Casseles/pcie_to_sata/docs/images/bottom.png

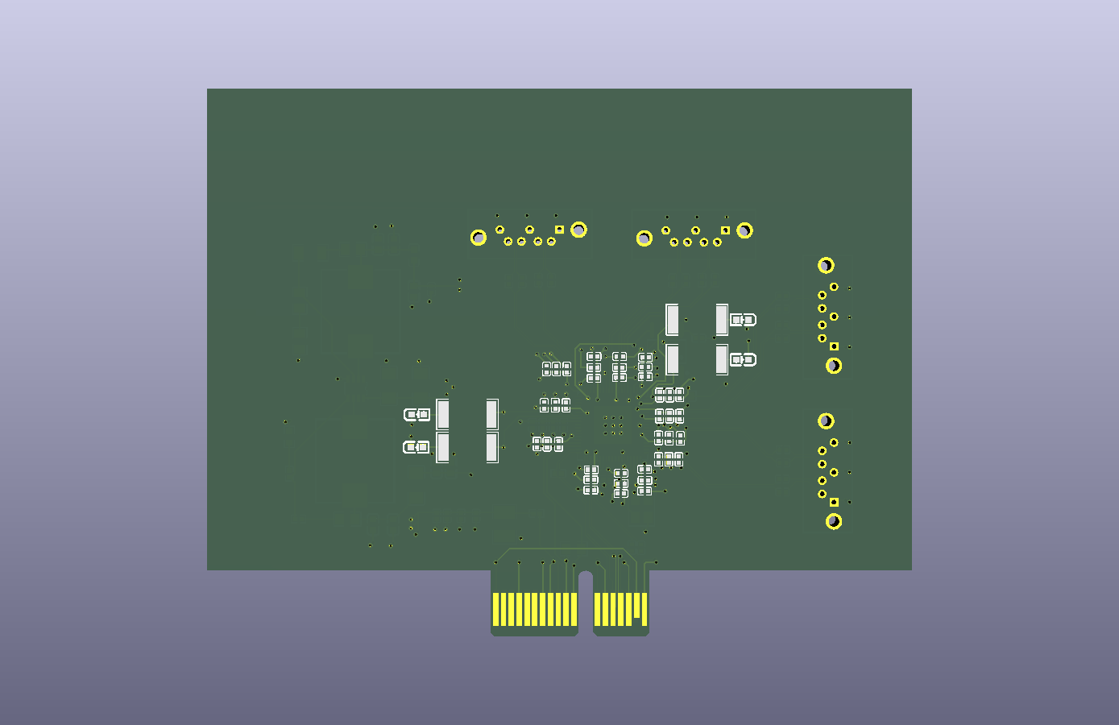
docs/images/bottom.png
