Casseles/pcie_to_sata/docs/images/bottom_raytracing.png

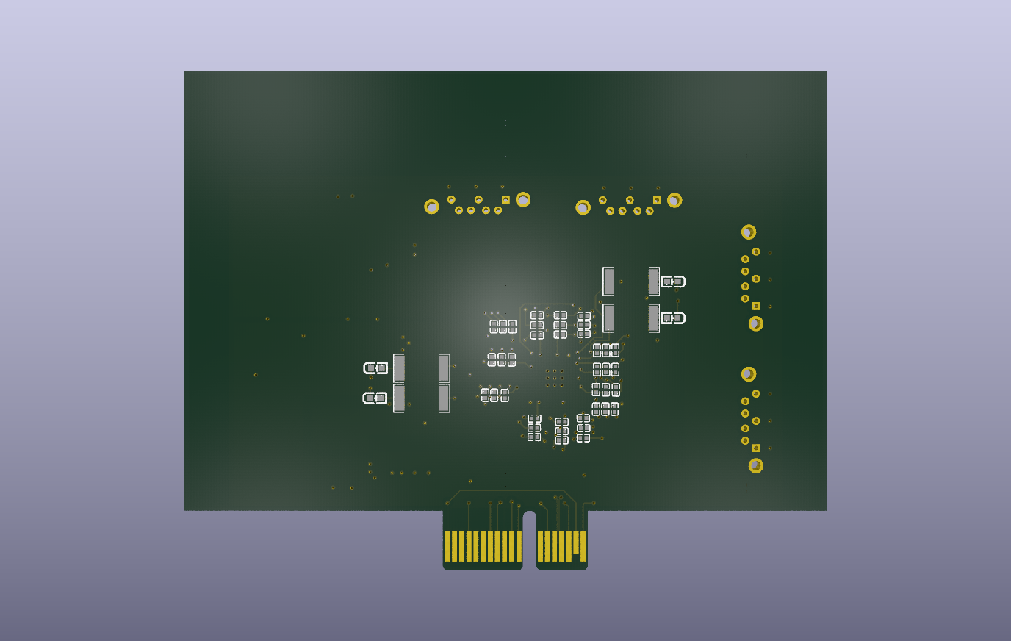
docs/images/bottom_raytracing.png
