Casseles/pcie_to_sata/docs/images/top.png

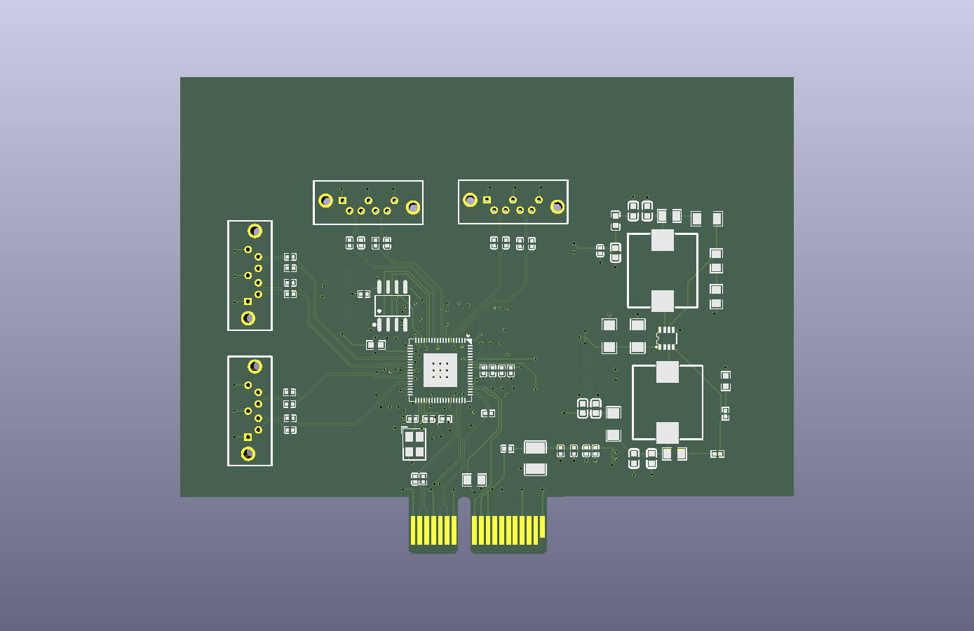
docs/images/top.png
