Casseles/pcie_to_sata/manufacturing/Gerber_bom.csv

Designator | Footprint | Quantity | Value | LCSC Part #
C1, C11, C12, C15, C16, C2, C20, C23, C24, C25, C26, C27, C49, C5, C53, C59, C60, C65, C66, C71, C72 | C0402 | 21 | .1u | C85735
C10, C14 | C1206 | 2 | 22u | C1859
C13 | C0603 | 1 | 1u | C1691
C17 | C1210 | 1 | 100u | C90143
C18, C19, C22, C28, C50, C55, C56, C62, C68 | C0402 | 9 | .01u | C85735
C21, C57, C63, C69 | C0402 | 4 | 1000p | C85735
C29, C31, C32, C33, C34, C35, C36, C37, C38, C39, C40, C41, C42, C43, C44, C45, C46, C58, C61, C64, C67, C70, C73 | C0402 | 23 | .01u | C1523
C3, C54, C77, C8 | C0402 | 4 | .1u | C1525
C30 | C0402 | 1 | 1000p | C1523
C4, C51, C52, C6 | C0603 | 4 | 10u | C1691
C47, C48 | C0402 | 2 | 18p | C1523
C7, C9 | C0603 | 2 | 2.2u | C1691
C74, C76, C78, C79 | C0402 | 4 | .01u | C1525
C75 | C0402 | 1 | 1000p | C1525
D1, D2, D3, D4 | LED-SMD_L1.6-W0.8-R-RD | 4 | LED | C2286
FB1 | L0603 | 1 | FerriteBead | C963848
FB2 | L1206 | 1 | FerriteBead | C16902
J1, J2, J3, J4 | CONN-TH_SATA-501-M07S1BY-A | 4 | ~ | C7500838
J5 | BUS_PCIexpress_x1 | 1 | Bus_PCI_Express_x1
L1, L2 | IND-SMD_L10.8-W10.2_IHLP4040DZER1R8M11 | 2 | 1.5u | C845071
R1 | R0805 | 1 | 4,7k | C1404
R10 | R0805 | 1 | 390k | C1404
R11 | R0805 | 1 | 22k | C17560
R12 | R0402 | 1 | 0 | C17168
R13 | R0805 | 1 | 560k | C1404
R14 | R0402 | 1 | 39k | C25076
R15 | R0402 | 1 | 910k | C11866
R16, R4 | R0603 | 2 | 10k | C15401
R2 | R0402 | 1 | 6.04k | C25913
R3 | R0805 | 1 | 750k | C1404
R5 | R1206 | 1 | 56k | C4513
R6, R7, R8, R9 | R2512 | 4 | 100 | C15262
RN1 | R0402 | 1 | 100 | C425365
U1 | QFN-76_L9.0-W9.0-P0.40-TL-EP4.9 | 1 | ~ | C713244
U2 | TSOT-23-8_L2.9-W1.6-P0.65-LS2.8-BL | 1 | ~ | C3194324
U3 | SOP-8_L5.0-W4.0-P1.27-LS6.0-BL | 1 | FM25Q08B-SO-T-G | C696825
X1 | CRYSTAL-SMD_4P-L3.2-W2.5-BL-2 | 1 | X322525MSB4SI | C13740
