Casseles/pcie_to_sata/docs/schematics.pdf

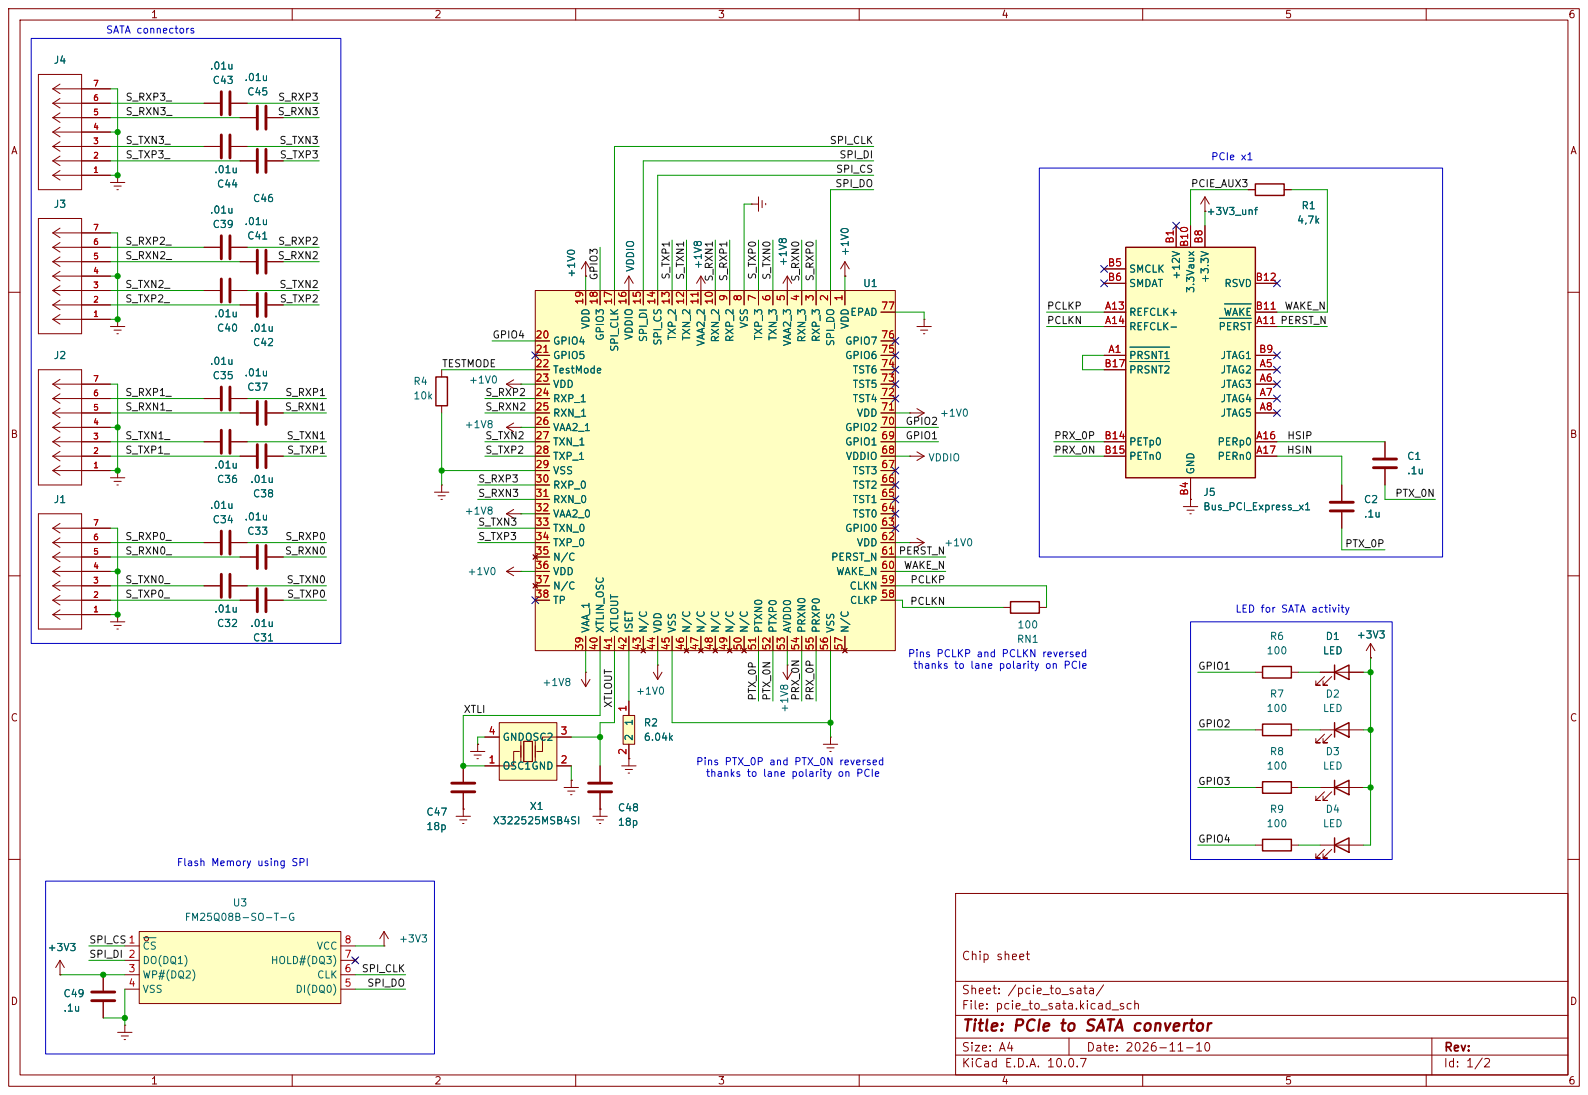
[picture p5: page 1]

PCIe x1 Pins PTX_0P and PTX_0N reversed

LED for SATA activity Pins PCLKP and PCLKN reversed

thanks to lane polarity on PCIe

thanks to lane polarity on PCIe C47

Flash Memory using SPI

Sheet: /pcie_to_sata/
File: pcie_to_sata.kicad_sch
Title: PCIe to SATA convertor

Size: A4 | Rev:
KiCad E.D.A. 10.0.7 | Id: 1/2

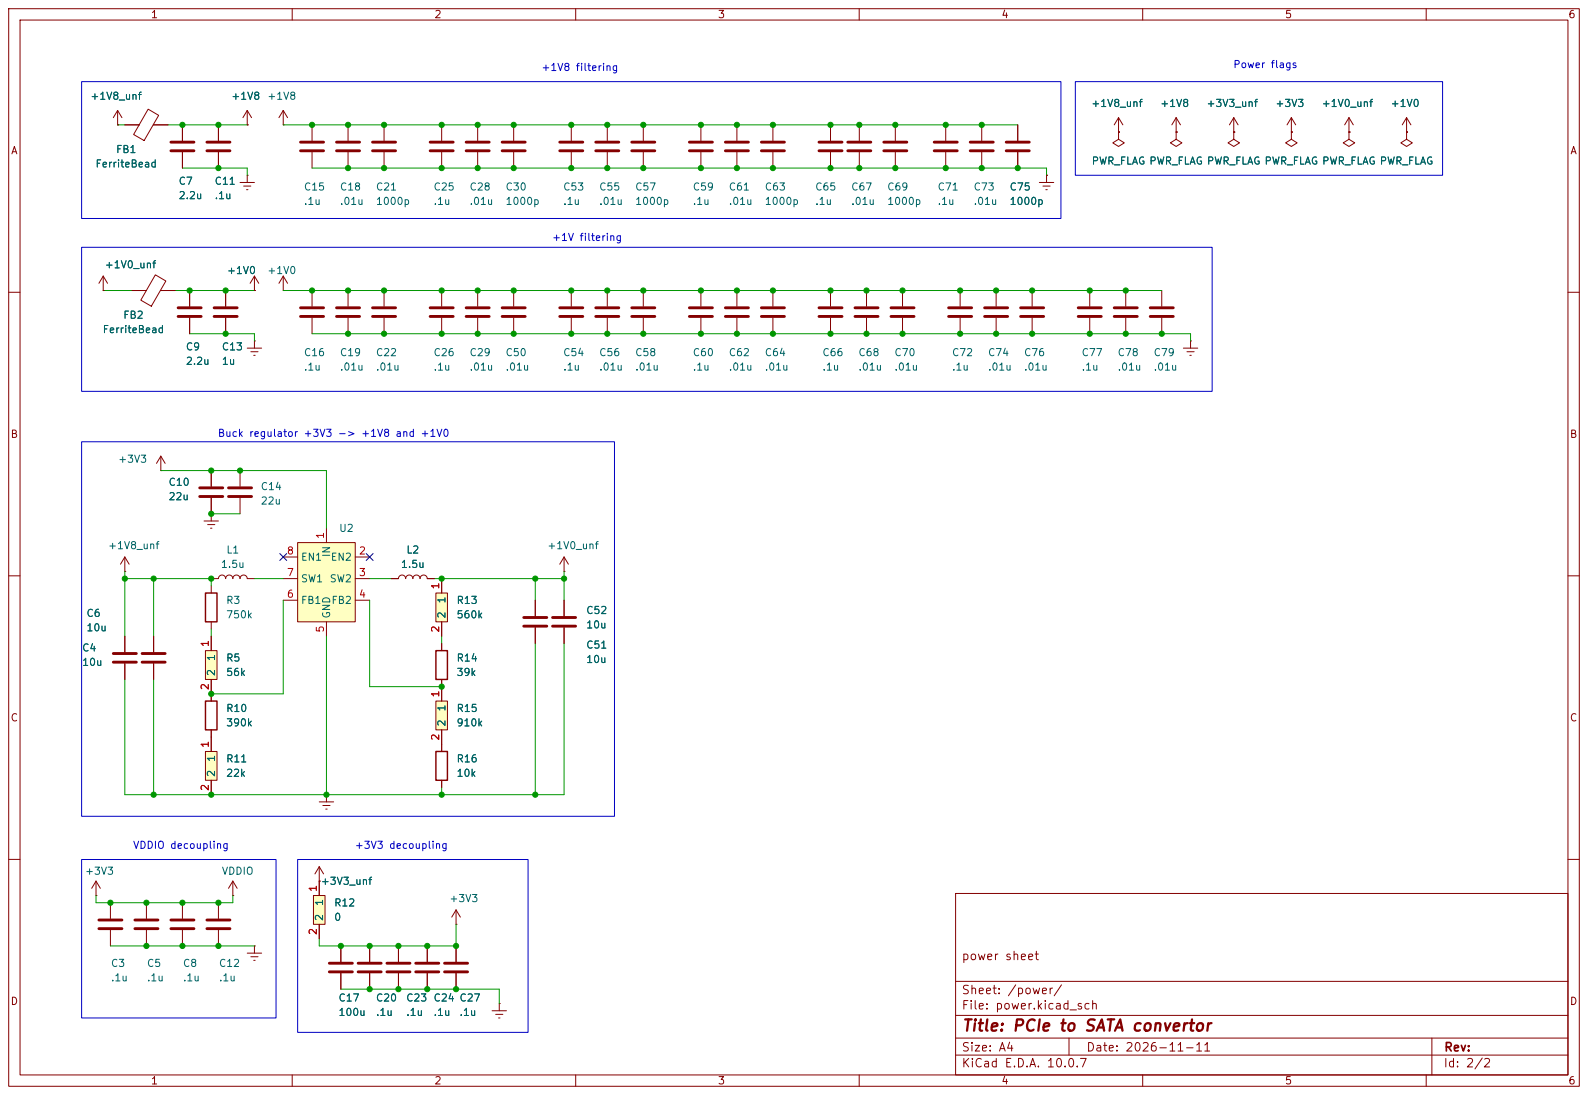
[picture p6: page 2]

Sheet: /power/
File: power.kicad_sch
Title: PCIe to SATA convertor

Size: A4 | Rev:
KiCad E.D.A. 10.0.7 | Id: 2/2
