Casseles/pcie_to_sata/hardware/pcie_to_sata.kicad_pcb

## KiCad design hardware/pcie_to_sata.kicad_pcb (2026-11-11)

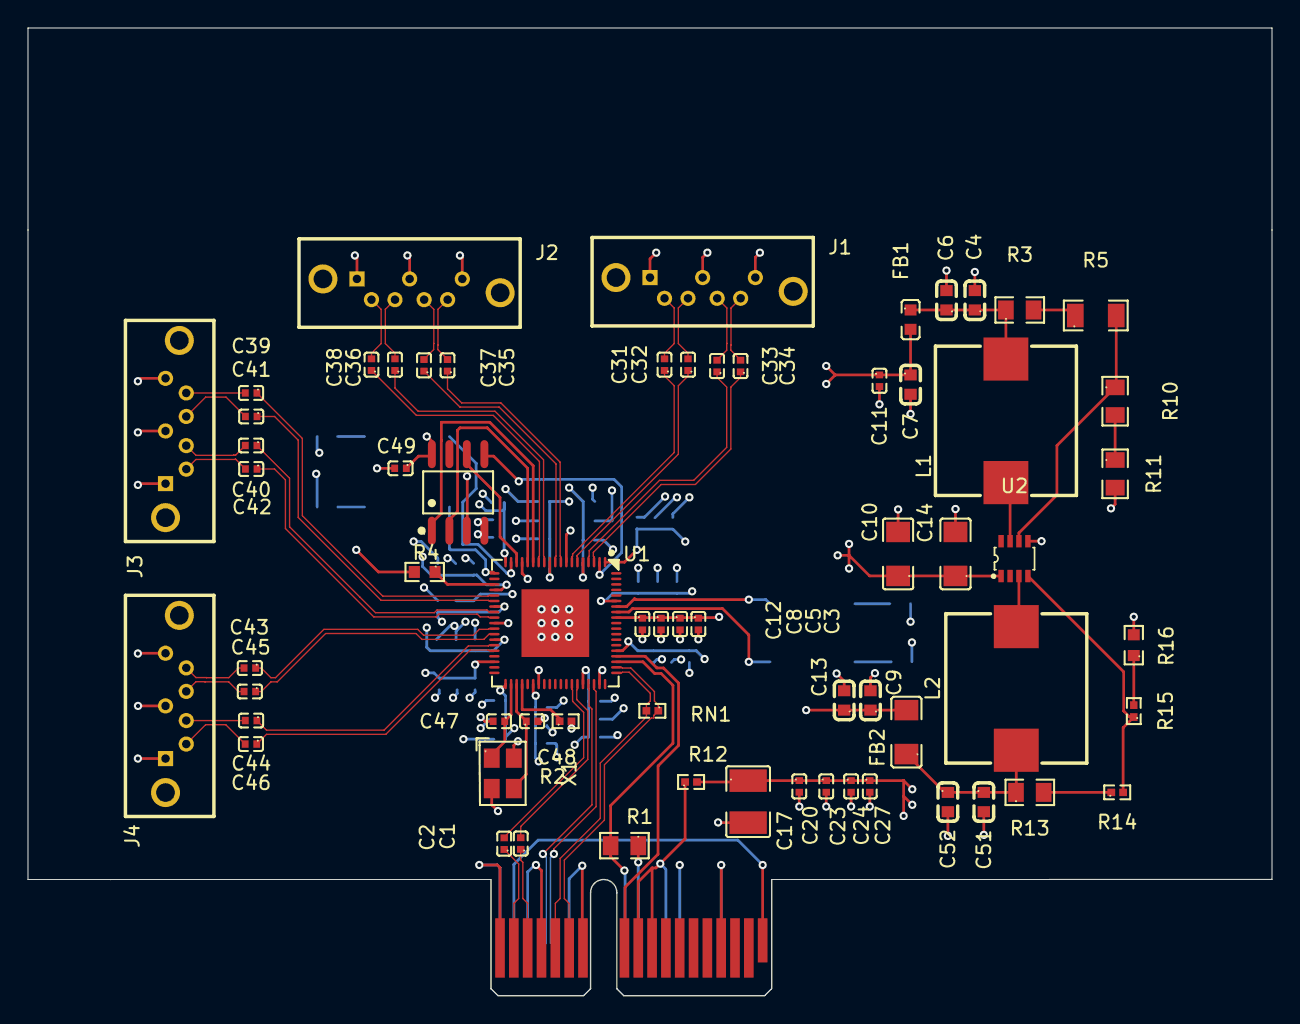
[picture p14: board pcie_to_sata.kicad_pcb from above]

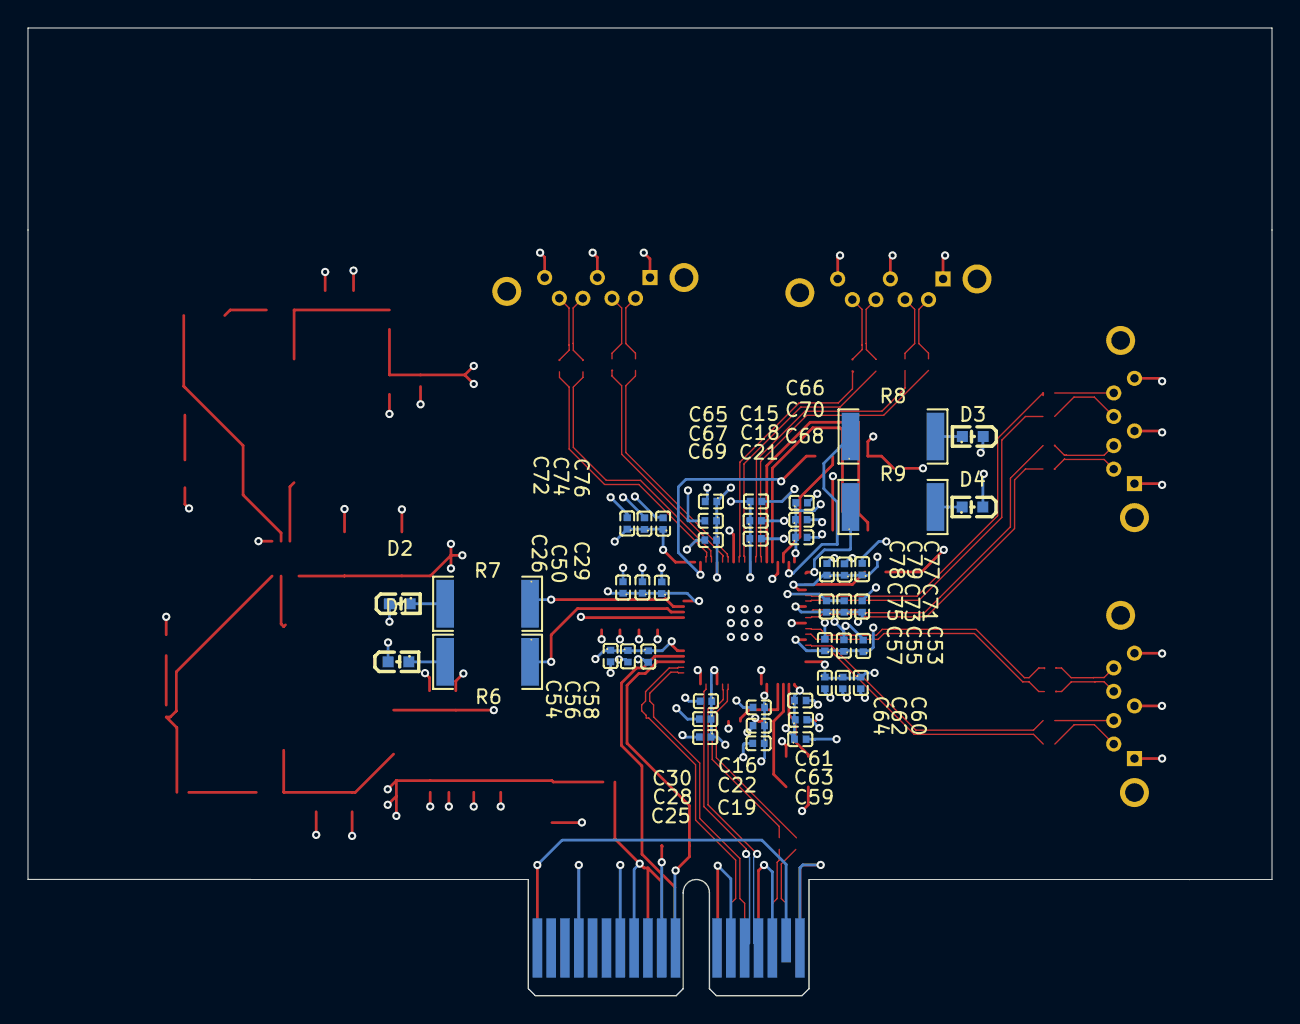
[picture p15: board pcie_to_sata.kicad_pcb from below]

Board: 4 copper layers, 90.0 x 70.0 mm, 113 parts (48 on the bottom side), 75 nets.

Parts:
C1, C2, C3, C5, C8, C11, C12, C15, C16, C20, C23, C24, C25, C26, C27, C49, C53, C54, C59, C60, C65, C66, C71, C72, C77: .1u; C0402
C4, C6, C51, C52: 10u; C0603
C7, C9: 2.2u; C0603
C10, C14: 22u; C1206
C13: 1u; C0603
C17: 100u; C1210
C18, C19, C22, C28, C29, C31, C32, C33, C34, C35, C36, C37, C38, C39, C40, C41, C42, C43, C44, C45, C46, C50, C55, C56, C58, C61, C62, C64, C67, C68, C70, C73, C74, C76, C78, C79: .01u; C0402
C21, C30, C57, C63, C69, C75: 1000p; C0402
C47, C48: 18p; C0402
D1, D2, D3, D4: LED; LED-SMD_L1.6-W0.8-R-RD
FB1: FerriteBead; L0603
FB2: FerriteBead; L1206
J1, J2, J3, J4: CONN-TH_SATA-501-M07S1BY-A
J5: Bus_PCI_Express_x1; BUS_PCIexpress_x1
L1, L2: 1.5u; IND-SMD_L10.8-W10.2_IHLP4040DZER1R8M11
R1: 4,7k; R0805
R2: 6.04k; R0402
R3: 750k; R0805
R4, R16: 10k; R0603
R5: 56k; R1206
R6, R7, R8, R9: 100; R2512
R10: 390k; R0805
R11: 22k; R0805
R12: 0; R0402
R13: 560k; R0805
R14: 39k; R0402
R15: 910k; R0402
RN1: 100; R0402
U1: QFN-76_L9.0-W9.0-P0.40-TL-EP4.9
U2: TSOT-23-8_L2.9-W1.6-P0.65-LS2.8-BL
U3: FM25Q08B-SO-T-G; SOP-8_L5.0-W4.0-P1.27-LS6.0-BL
X1: X322525MSB4SI; CRYSTAL-SMD_4P-L3.2-W2.5-BL-2

Connections:
+1V0: C9.1, C13.1, C16.1, C19.1, C22.1, C26.1, C29.1, C50.1, C54.1, C56.1, C58.1, C60.1, C62.1, C64.1, C66.1, C68.1, C70.1, C72.1, C74.1, C76.1, C77.1, C78.1, C79.1, FB2.2, U1.1 (VDD), U1.19 (VDD), U1.23 (VDD), U1.36 (VDD), U1.44 (VDD), U1.62 (VDD), U1.71 (VDD)
+1V0_unf: C51.1, C52.1, FB2.1, L2.2, R13.1
+1V8: C7.1, C11.1, C15.1, C18.1, C21.1, C25.1, C28.1, C30.1, C53.1, C55.1, C57.1, C59.1, C61.1, C63.1, C65.1, C67.1, C69.1, C71.1, C73.1, C75.1, FB1.2, U1.5 (VAA2_3), U1.11 (VAA2_2), U1.26 (VAA2_1), U1.32 (VAA2_0), U1.39 (VAA_1), U1.53 (AVDD0)
+1V8_unf: C4.1, C6.1, FB1.1, L1.1, R3.1
+3V3: C3.1, C5.1, C8.1, C10.1, C12.1, C14.1, C17.1, C20.1, C23.1, C24.1, C27.1, C49.1, D1.2 (A), D2.2 (A), D3.2 (A), D4.2 (A), R12.2, U1.16 (VDDIO), U1.68 (VDDIO), U2.1 (IN), U3.3 (WP#(DQ2)), U3.8 (VCC)
+3V3_unf: J5.A9 (+3.3V), J5.A10 (+3.3V), J5.B8 (+3.3V), R12.1
/pcie_to_sata/GPIO1: R6.1, U1.69 (GPIO1)
/pcie_to_sata/GPIO2: R7.1, U1.70 (GPIO2)
/pcie_to_sata/GPIO3: R8.1, U1.18 (GPIO3)
/pcie_to_sata/GPIO4: R9.1, U1.20 (GPIO4)
/pcie_to_sata/HSIN: C2.1, J5.A17 (PERn0)
/pcie_to_sata/HSIP: C1.1, J5.A16 (PERp0)
/pcie_to_sata/PCIE_AUX3: J5.B10 (3.3Vaux), R1.1
/pcie_to_sata/PCLKN: J5.A14 (REFCLK-), RN1.2, U1.58 (CLKP)
/pcie_to_sata/PCLKP: J5.A13 (REFCLK+), RN1.1, U1.59 (CLKN)
/pcie_to_sata/PERST_N: J5.A11 (~PERST), U1.61 (PERST_N)
/pcie_to_sata/PRX_0N: J5.B15 (PETn0), U1.54 (PRXN0)
/pcie_to_sata/PRX_0P: J5.B14 (PETp0), U1.55 (PRXP0)
/pcie_to_sata/PTX_0N: C1.2, U1.52 (PTXP0)
/pcie_to_sata/PTX_0P: C2.2, U1.51 (PTXN0)
/pcie_to_sata/SPI_CLK: U1.17 (SPI_CLK), U3.6 (CLK)
/pcie_to_sata/SPI_CS: U1.14 (SPI_CS), U3.1 (~CS)
/pcie_to_sata/SPI_DI: U1.15 (SPI_DI), U3.2 (DO(DQ1))
/pcie_to_sata/SPI_DO: U1.2 (SPI_DO), U3.5 (DI(DQ0))
/pcie_to_sata/S_RXN0: C33.1, U1.4 (RXN_3)
/pcie_to_sata/S_RXN0_: C33.2, J1.5
/pcie_to_sata/S_RXN1: C37.1, U1.10 (RXN_2)
/pcie_to_sata/S_RXN1_: C37.2, J2.5
/pcie_to_sata/S_RXN2: C41.1, U1.25 (RXN_1)
/pcie_to_sata/S_RXN2_: C41.2, J3.5
/pcie_to_sata/S_RXN3: C45.1, U1.31 (RXN_0)
/pcie_to_sata/S_RXN3_: C45.2, J4.5
/pcie_to_sata/S_RXP0: C34.1, U1.3 (RXP_3)
/pcie_to_sata/S_RXP0_: C34.2, J1.6
/pcie_to_sata/S_RXP1: C35.1, U1.9 (RXP_2)
/pcie_to_sata/S_RXP1_: C35.2, J2.6
/pcie_to_sata/S_RXP2: C39.1, U1.24 (RXP_1)
/pcie_to_sata/S_RXP2_: C39.2, J3.6
/pcie_to_sata/S_RXP3: C43.1, U1.30 (RXP_0)
/pcie_to_sata/S_RXP3_: C43.2, J4.6
/pcie_to_sata/S_TXN0: C32.1, U1.6 (TXN_3)
/pcie_to_sata/S_TXN0_: C32.2, J1.3
/pcie_to_sata/S_TXN1: C36.1, U1.12 (TXN_2)
/pcie_to_sata/S_TXN1_: C36.2, J2.3
/pcie_to_sata/S_TXN2: C40.1, U1.27 (TXN_1)
/pcie_to_sata/S_TXN2_: C40.2, J3.3
/pcie_to_sata/S_TXN3: C44.1, U1.33 (TXN_0)
/pcie_to_sata/S_TXN3_: C44.2, J4.3
/pcie_to_sata/S_TXP0: C31.1, U1.7 (TXP_3)
/pcie_to_sata/S_TXP0_: C31.2, J1.2
/pcie_to_sata/S_TXP1: C38.1, U1.13 (TXP_2)
/pcie_to_sata/S_TXP1_: C38.2, J2.2
/pcie_to_sata/S_TXP2: C42.1, U1.28 (TXP_1)
/pcie_to_sata/S_TXP2_: C42.2, J3.2
/pcie_to_sata/S_TXP3: C46.1, U1.34 (TXP_0)
/pcie_to_sata/S_TXP3_: C46.2, J4.2
/pcie_to_sata/TESTMODE: R4.1, U1.22 (TestMode)
/pcie_to_sata/WAKE_N: J5.B11 (~WAKE), R1.2, U1.60 (WAKE_N)
/pcie_to_sata/XTLI: C47.1, U1.40 (XTLIN_OSC), X1.1 (OSC1)
/pcie_to_sata/XTLOUT: C48.1, U1.41 (XTLOUT), X1.3 (OSC2)
GNDREF: C3.2, C4.2, C5.2, C6.2, C7.2, C8.2, C9.2, C10.2, C11.2, C12.2, C13.2, C14.2, C15.2, C16.2, C17.2, C18.2, C19.2, C20.2, C21.2, C22.2, C23.2, C24.2, C25.2, C26.2, C27.2, C28.2, C29.2, C30.2, C47.2, C48.2, C49.2, C50.2, C51.2, C52.2, C53.2, C54.2, C55.2, C56.2, C57.2, C58.2, C59.2, C60.2, C61.2, C62.2, C63.2, C64.2, C65.2, C66.2, C67.2, C68.2, C69.2, C70.2, C71.2, C72.2, C73.2, C74.2, C75.2, C76.2, C77.2, C78.2, C79.2, J1.1, J1.4, J1.7, J2.1, J2.4, J2.7, J3.1, J3.4, J3.7, J4.1, J4.4, J4.7, J5.A4 (GND), J5.A12 (GND), J5.A15 (GND), J5.A18 (GND), J5.B4 (GND), J5.B7 (GND), J5.B13 (GND), J5.B16 (GND), J5.B18 (GND), R2.2, R4.2, R11.2, R16.2, U1.8 (VSS), U1.29 (VSS), U1.45 (VSS), U1.56 (VSS), U1.77 (EPAD), U2.5 (GND), U3.4 (VSS), X1.2 (GND), X1.4 (GND)
unnamed: D1.1 (K), R6.2
unnamed: D2.1 (K), R7.2
unnamed: D3.1 (K), R8.2
unnamed: D4.1 (K), R9.2
unnamed: J5.A1 (~PRSNT1), J5.B17 (~PRSNT2)
unnamed: R3.2, R5.1
unnamed: R10.2, R11.1
unnamed: R13.2, R14.1
unnamed: R15.2, R16.1
unnamed: R2.1, U1.42 (ISET)
unnamed: R5.2, R10.1, U2.6 (FB1)
unnamed: R14.2, R15.1, U2.4 (FB2)
unnamed: L1.2, U2.7 (SW1)
unnamed: L2.1, U2.3 (SW2)
