Casseles/pcie_to_sata/(commit log)

2026-11-10 Feature: Import pcie_to_sata projet
    [Gerber_bom.csv, Gerber_designators.csv, Gerber_positions.csv, TSX-3225_25.0000MF18X-G0.step, pcie_to_sata.kicad_pcb, pcie_to_sata.kicad_sch, power.kicad_sch]
2026-11-10 Fix: deletion of migration folder
    [Gerber_bom.csv, Gerber_designators.csv, Gerber_positions.csv, TSX-3225_25.0000MF18X-G0.step, pcie_to_sata.kicad_pcb, pcie_to_sata.kicad_sch, power.kicad_sch]
2026-11-10 Feature: pcb layout added
2026-11-11 Feature : differential pair (SATA & PCIe) + files storage
    [Gerber_bom.csv, Gerber_designators.csv, Gerber_positions.csv, TSX-3225_25.0000MF18X-G0.step, pcie_to_sata.kicad_pcb, pcie_to_sata.kicad_sch, power.kicad_sch]
